poornareddy396/Underwater_ROV/electronics/README.md

# Electronics

Schematics, wiring, pinouts, power architecture and motor-control documentation.
