poornareddy396/Underwater_ROV/mechanical/README.md

# Mechanical Design

CAD models, drawings, STL files, assemblies and waterproofing-related mechanical work.
