poornareddy396/Underwater_ROV/firmware/README.md

# Firmware

STM32 embedded firmware and communication protocol documentation.
