poornareddy396/Underwater_ROV/software/README.md

# Software

Raspberry Pi software, web interface, computer vision and ground-station components.
