poornareddy396/Underwater_ROV/firmware/stm32/README.md

# STM32 Firmware

STM32F411 Blackpill CubeIDE project used by the underwater ROV. Generated build/debug artifacts are intentionally excluded from version control.
