poornareddy396/Underwater_ROV/software/raspberry_pi/README.md

# Raspberry Pi Software

Raspberry Pi application and web interface for the underwater ROV.
