poornareddy396/Underwater_ROV/mechanical/iteration_2/fusion_360_final_model.png

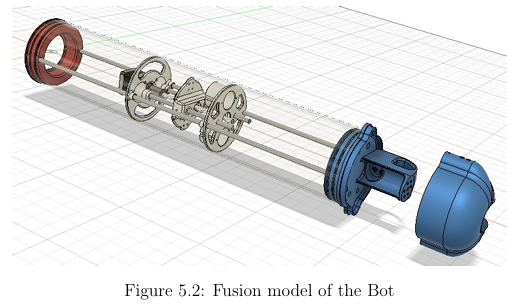
mechanical/iteration_2/fusion_360_final_model.png
