poornareddy396/Underwater_ROV/mechanical/iteration_2/mechanical_design_2_CAP_DESIGN.png

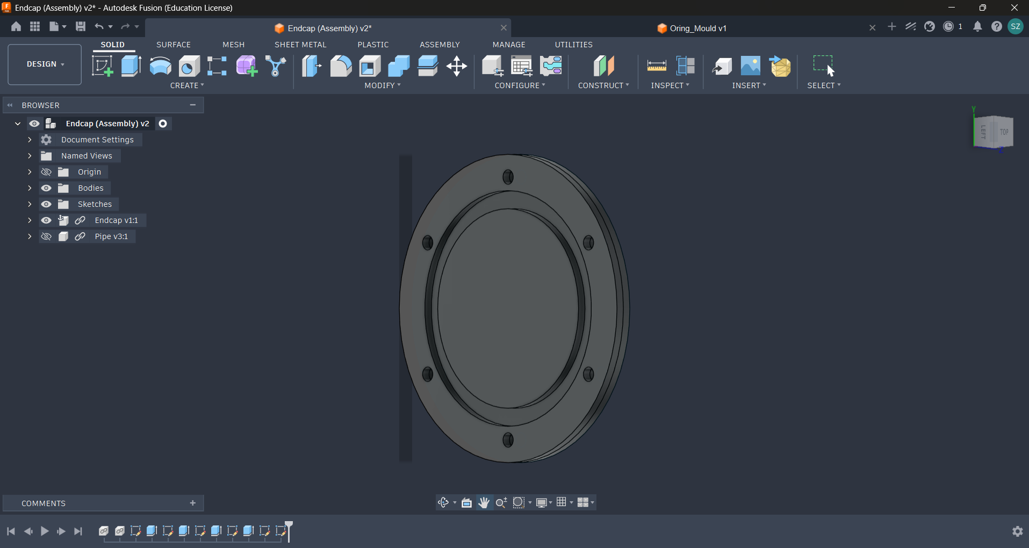
mechanical/iteration_2/mechanical_design_2_CAP_DESIGN.png
