poornareddy396/Underwater_ROV/mechanical/iteration_2/mechanical_design_2_IMG_20260821_114951.jpg

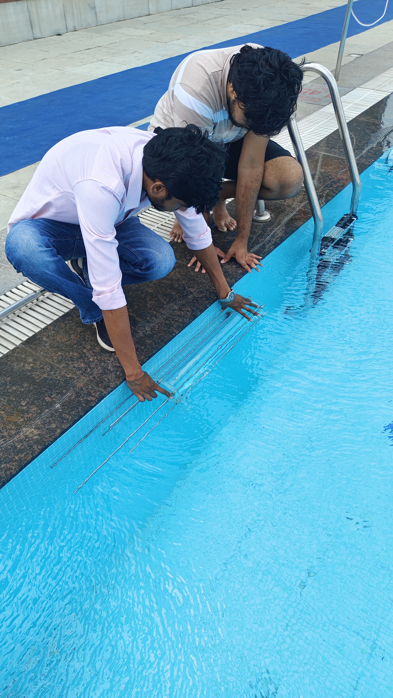
mechanical/iteration_2/mechanical_design_2_IMG_20260821_114951.jpg
