poornareddy396/Underwater_ROV/mechanical/iteration_2/mechanical_design_2_IMG_20260921_133137.jpg

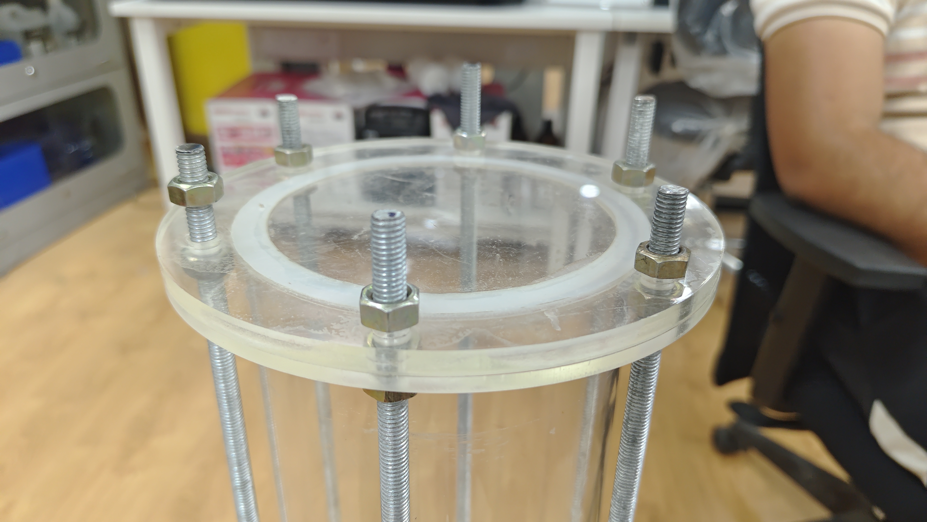
mechanical/iteration_2/mechanical_design_2_IMG_20260921_133137.jpg
