poornareddy396/Underwater_ROV/schematics/schematics_and_components.pdf

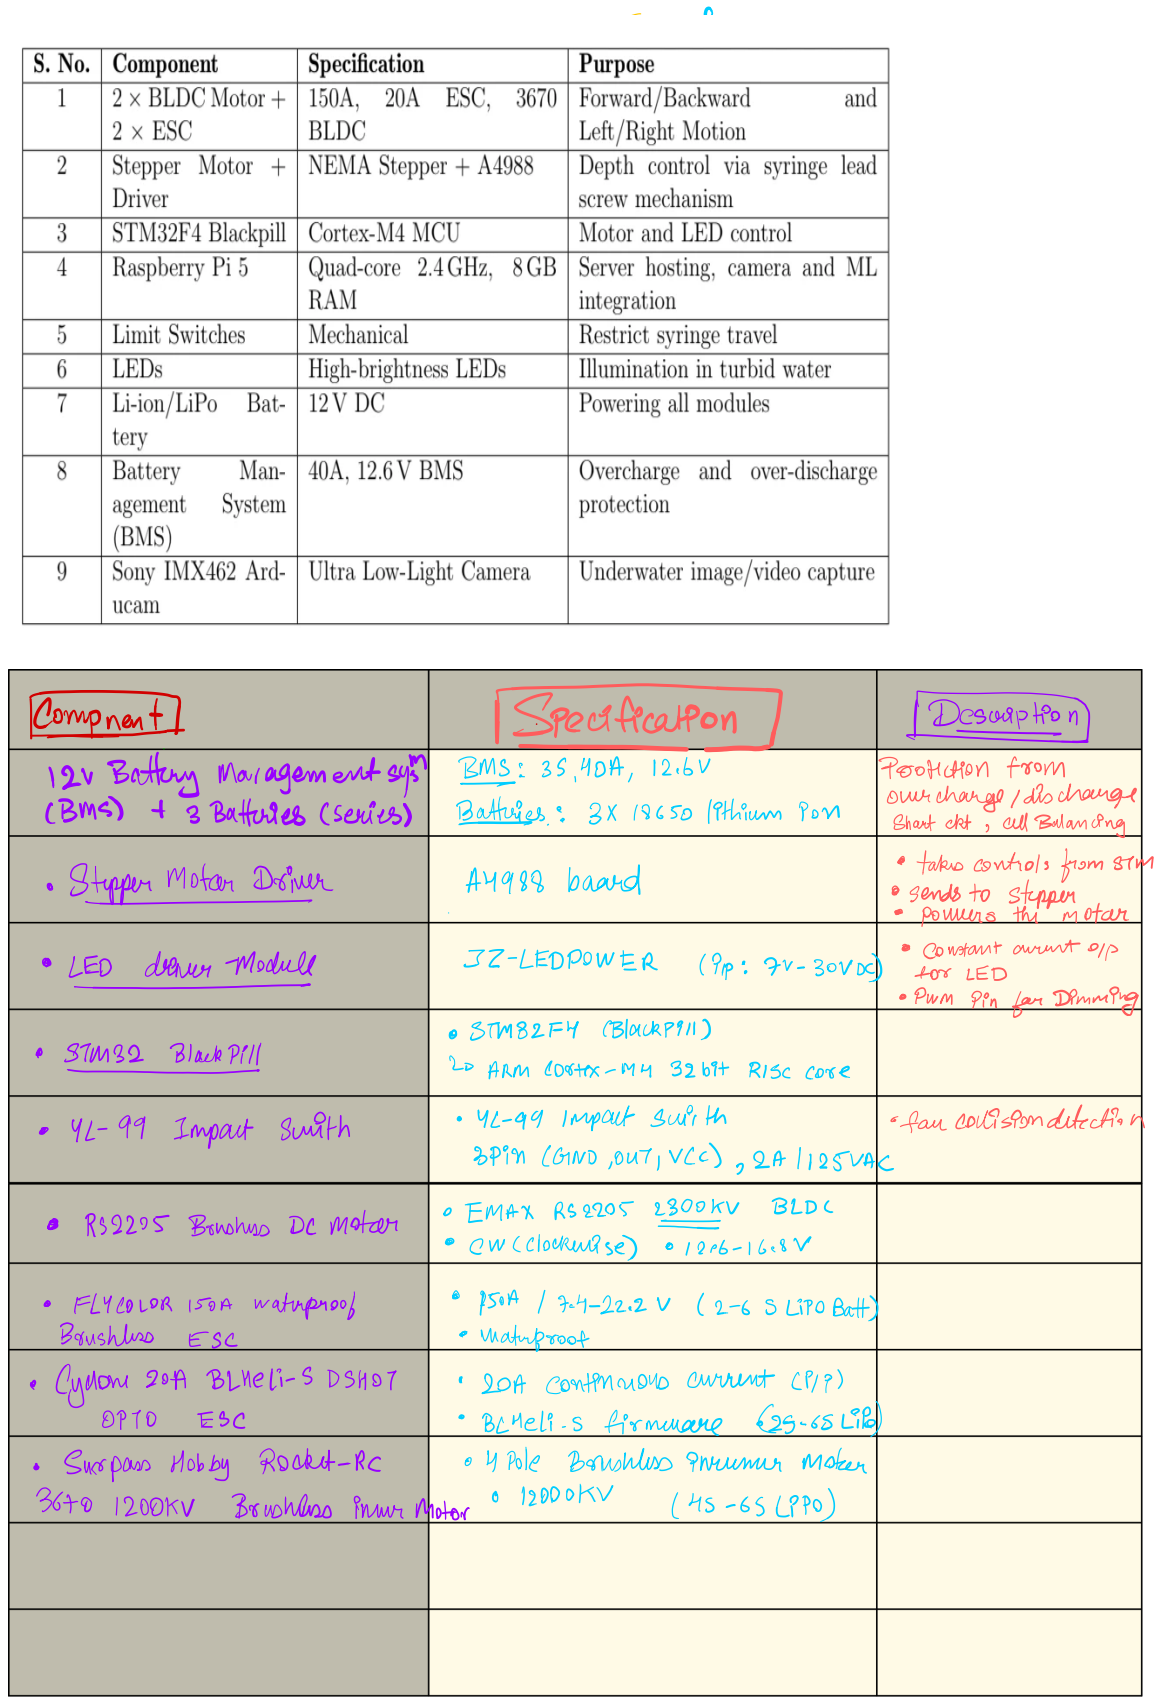
[picture p20: page 1]

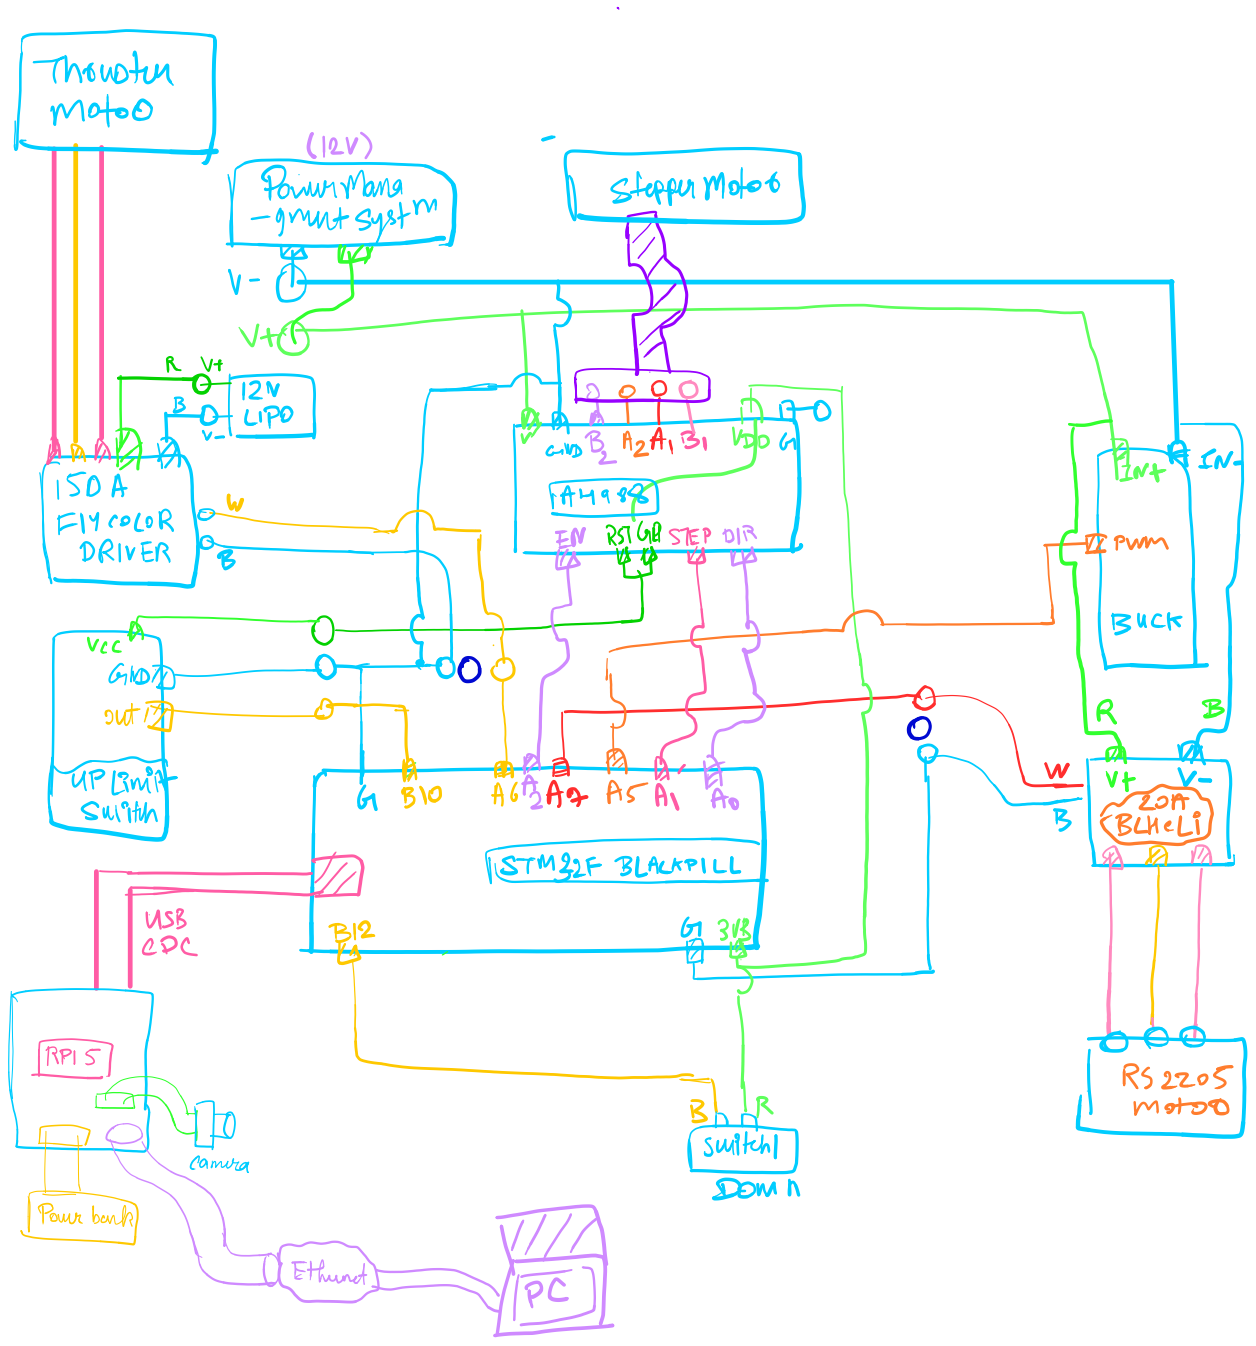
[picture p21: page 2]
