poornareddy396/Underwater_ROV/schematics/hand_drawn_electrical_wiring.png

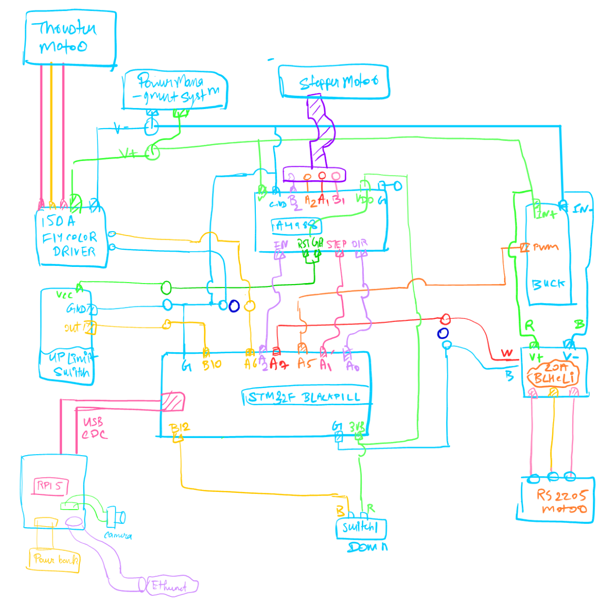
schematics/hand_drawn_electrical_wiring.png
