poornareddy396/Underwater_ROV/CHANGELOG.md

# Changelog

## Initial Repository
- Added complete project repository structure.
- Added project README.
- Added uploaded project report.
- Added documentation, mechanical, electronics, firmware, software,
  experiments, results, media, data, BOM and scripts directories.
