poornareddy396/Underwater_ROV/firmware/stm32/Core/Src/main.c

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
/* Includes ------------------------------------------------------------------*/
#include "main.h"
#include "usb_device.h"

/* USER CODE BEGIN PD */
#define MIN_PULSE 1000      // microseconds
#define MAX_PULSE 2000      // microseconds
#define MID_PULSE 1500      // microseconds

#define STAY_LOW_TIME 5000  // milliseconds
#define RAMP_TIME 15000     // milliseconds
#define EN_PIN     GPIO_PIN_2
#define STEP_PIN   GPIO_PIN_1
#define DIR_PIN    GPIO_PIN_0
#define EN_PORT    GPIOA
#define STEP_PORT  GPIOA
#define DIR_PORT   GPIOA

#define UP_LIMIT_PIN      GPIO_PIN_10   // PB10
#define DOWN_LIMIT_PIN    GPIO_PIN_12   // PB12
#define LIMIT_PORT        GPIOB
/* USER CODE END PD */

TIM_HandleTypeDef htim2;
TIM_HandleTypeDef htim3;

/* USER CODE BEGIN PV */
volatile uint8_t up_limit_reached = 0;
volatile uint8_t down_limit_reached = 0;
int right = 0;
int left = 0;
int base_pulse = 1490;
int right_min = 1300;
int left_max  = 1600;

float progress;

/* “reported�? flags so we send LIMIT:UP only once until state changes */
volatile uint8_t up_limit_reported = 0;
volatile uint8_t down_limit_reported = 0;


/* debounce timers */
uint32_t startTime = 0;
uint32_t speed = 0;
int fw_bw = 1;
int stop = 1;
int direction = 1;
unsigned long lastDebounceUp = 0;
unsigned long lastDebounceDown = 0;
const unsigned long debounceDelay = 50;
uint8_t light = 0;
uint8_t fw_mot_start = 0;
extern uint8_t CDC_Transmit_FS(uint8_t* Buf, uint16_t Len);
/* USER CODE END PV */

void SystemClock_Config(void);
static void MX_GPIO_Init(void);
static void MX_TIM3_Init(void);
static void MX_TIM2_Init(void);
/* USER CODE BEGIN 0 */

//void check_limit_switches(void) {
//    static uint8_t last_up_state = 0;
//    static uint8_t last_down_state = 0;
//
//    uint8_t up_state = HAL_GPIO_ReadPin(LIMIT_PORT, UP_LIMIT_PIN);
//    uint8_t down_state = HAL_GPIO_ReadPin(LIMIT_PORT, DOWN_LIMIT_PIN);
//
//    if (up_state && !last_up_state) {
//        up_limit_reached = 1;
//        CDC_Transmit_FS((uint8_t*)"LIMIT:UP\n", strlen("LIMIT:UP\n"));
//    }
//    else if (!up_state && last_up_state) {
//        up_limit_reached = 0;
//        CDC_Transmit_FS((uint8_t*)"LIMIT:CLEAR\n", strlen("LIMIT:CLEAR\n"));
//    }
//
//    if (down_state && !last_down_state) {
//        down_limit_reached = 1;
//        CDC_Transmit_FS((uint8_t*)"LIMIT:DOWN\n", strlen("LIMIT:DOWN\n"));
//    }
//    else if (!down_state && last_down_state) {
//        down_limit_reached = 0;
//        CDC_Transmit_FS((uint8_t*)"LIMIT:CLEAR\n", strlen("LIMIT:CLEAR\n"));
//    }
//
//    last_up_state = up_state;
//    last_down_state = down_state;
//}

void delay_us(uint32_t us)
{
  uint32_t start = DWT->CYCCNT;
  uint32_t ticks = us * (HAL_RCC_GetHCLKFreq() / 1000000);
  while ((DWT->CYCCNT - start) < ticks);
}
void singleStep(int dir, int speed_us)
{
  HAL_GPIO_WritePin(DIR_PORT, DIR_PIN, dir ? GPIO_PIN_SET : GPIO_PIN_RESET);
  HAL_GPIO_WritePin(STEP_PORT, STEP_PIN, GPIO_PIN_SET);
  delay_us(speed_us);
  HAL_GPIO_WritePin(STEP_PORT, STEP_PIN, GPIO_PIN_RESET);
  delay_us(speed_us);
}

/* USER CODE BEGIN 0 */
void HAL_GPIO_EXTI_Callback(uint16_t GPIO_Pin)
{
    uint32_t current = HAL_GetTick();

    if (GPIO_Pin == UP_LIMIT_PIN)
    {
        if ((current - lastDebounceUp) > debounceDelay)
        {
            lastDebounceUp = current;
            up_limit_reached = 1;         // tell main loop we hit top limit
            //up_limit_reported = 0;// allow main to report once
            down_limit_reached = 0;
        }
    }
    else if (GPIO_Pin == DOWN_LIMIT_PIN)
    {
        if ((current - lastDebounceDown) > debounceDelay)
        {
            lastDebounceDown = current;
            down_limit_reached = 1;
            //down_limit_reported = 0;
            up_limit_reached = 0;
        }
    }
}
int set_motor_speed_fw(uint32_t speed_percent) {
    if (speed_percent > 100) speed_percent = 100;

    // Map 0–100 → 1000–1500 µs
    uint32_t pulse = MID_PULSE + ((MAX_PULSE - MID_PULSE) * speed_percent) / 100;

    return pulse;

}
int set_motor_speed_bw(uint32_t speed_percent) {
    if (speed_percent > 100) speed_percent = 100;

    // Map 0–100 → 1000–1500 µs
    uint32_t pulse = MID_PULSE - ((MAX_PULSE - MID_PULSE) * speed_percent) / 100;

    return pulse;

}
/* USER CODE END 0 */

/**
  * @brief  The application entry point.
  * @retval int
  */
int main(void)
{

  /* MCU Configuration--------------------------------------------------------*/

  /* Reset of all peripherals, Initializes the Flash interface and the Systick. */
  HAL_Init();

  /* Configure the system clock */
  SystemClock_Config();

  /* Initialize all configured peripherals */
  MX_GPIO_Init();
  MX_USB_DEVICE_Init();
  MX_TIM3_Init();
  MX_TIM2_Init();
  /* USER CODE BEGIN 2 */
  HAL_GPIO_WritePin(EN_PORT, EN_PIN, GPIO_PIN_SET);  // Disable
  HAL_GPIO_WritePin(DIR_PORT, DIR_PIN, GPIO_PIN_RESET);
  HAL_GPIO_WritePin(STEP_PORT, STEP_PIN, GPIO_PIN_RESET);

      //HAL_GPIO_WritePin(EN_PORT, EN_PIN, GPIO_PIN_RESET); // Enable driver

      // Enable DWT Cycle Counter for microsecond delay
      CoreDebug->DEMCR |= CoreDebug_DEMCR_TRCENA_Msk;
      DWT->CYCCNT = 0;
      DWT->CTRL |= DWT_CTRL_CYCCNTENA_Msk;

      HAL_TIM_PWM_Start(&htim3, TIM_CHANNEL_1);
      HAL_TIM_PWM_Start(&htim3, TIM_CHANNEL_2);
      HAL_TIM_PWM_Start(&htim2, TIM_CHANNEL_1);
        startTime = HAL_GetTick();
  /* USER CODE END 2 */

  /* Infinite loop */
  /* USER CODE BEGIN WHILE */
  while (1)
  {

//	  check_limit_switches();
	  if (up_limit_reached)
	      {
	          // disable driver (active low enable in your code)
	          HAL_GPIO_WritePin(EN_PORT, EN_PIN, GPIO_PIN_SET); // disable motor driver

//	          if (!up_limit_reported)
//	          {
//	              // send event to host once
//	              CDC_Transmit_FS((uint8_t*)"LIMIT:UP\n", (uint16_t)strlen("LIMIT:UP\n"));
//	              up_limit_reported = 1;
//	          }

	          // do not step
	          HAL_Delay(1); // small delay to keep loop friendly
	      }
	      else if (down_limit_reached)
	      {
	          HAL_GPIO_WritePin(EN_PORT, EN_PIN, GPIO_PIN_SET); // disable driver

//	          if (!down_limit_reported)
//	          {
//	              CDC_Transmit_FS((uint8_t*)"LIMIT:DOWN\n", (uint16_t)strlen("LIMIT:DOWN\n"));
//	              down_limit_reported = 1;
//	          }
	          HAL_Delay(1);
	      }
	      else
	      {
	          // normal stepping: ensure driver enabled (active low)

	          if(stop) HAL_GPIO_WritePin(EN_PORT, EN_PIN, GPIO_PIN_SET); // disable motor driver
	          else HAL_GPIO_WritePin(EN_PORT, EN_PIN, GPIO_PIN_RESET);
	          // do one step (existing function)
	          singleStep(direction, 1000);
	      }

	  uint32_t elapsed = HAL_GetTick() - startTime;
	  	  	      uint32_t pulse_width;
	  	  	      uint32_t pulse;


	  	  	      if (elapsed < STAY_LOW_TIME)
	  	  	      {
	  	  	        pulse_width = MID_PULSE;
	  	  	    __HAL_TIM_SET_COMPARE(&htim3, TIM_CHANNEL_2, 1490);
	  	  	      }
	  	  	     else
	  	  	      {
	  	  	    	 if (fw_bw) pulse_width = set_motor_speed_fw(speed);
	  	  	    	 else pulse_width = set_motor_speed_bw(speed);
	  	  	    	if (right && !left)
	  	  	    	{
	  	  	    	    progress = (float)(elapsed - STAY_LOW_TIME) / RAMP_TIME;
	  	  	    	    if (progress < 0) progress = 0;
	  	  	    	    if (progress > 1) progress = 1;

	  	  	    	    pulse = base_pulse - progress * (base_pulse - right_min);

	  	  	    	    __HAL_TIM_SET_COMPARE(&htim3, TIM_CHANNEL_2, pulse);
	  	  	    	}

	  	  	    	// ----------- LEFT ----------------
	  	  	    	else if (left && !right)
	  	  	    	{
	  	  	    	    progress = (float)(elapsed - STAY_LOW_TIME) / RAMP_TIME;
	  	  	    	    if (progress < 0) progress = 0;
	  	  	    	    if (progress > 1) progress = 1;

	  	  	    	    pulse = base_pulse + progress * (left_max - base_pulse);

	  	  	    	    __HAL_TIM_SET_COMPARE(&htim3, TIM_CHANNEL_2, pulse);
	  	  	    	}

	  	  	    	// ----------- NEUTRAL -------------
	  	  	    	else
	  	  	    	{
	  	  	    	    pulse = base_pulse;
	  	  	    	    __HAL_TIM_SET_COMPARE(&htim3, TIM_CHANNEL_2, pulse);
	  	  	    	}
	  	  	      }

	  	  	      // Set pulse width (duty cycle)
	  	  	      if(fw_mot_start) __HAL_TIM_SET_COMPARE(&htim3, TIM_CHANNEL_1, pulse_width);
	  	  	      else __HAL_TIM_SET_COMPARE(&htim3, TIM_CHANNEL_1, MID_PULSE);
	  	  	      if(light) __HAL_TIM_SET_COMPARE(&htim2, TIM_CHANNEL_1, 5000);
	  	  	      else __HAL_TIM_SET_COMPARE(&htim2, TIM_CHANNEL_1, 0);
    /* USER CODE END WHILE */

    /* USER CODE BEGIN 3 */
  }
  /* USER CODE END 3 */
}

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
