poornareddy396/Underwater_ROV/firmware/stm32/Rpi_com.ioc

Mcu.UserName=STM32F411CEUx
PA0-WKUP.Signal=GPIO_Output
PA1.Signal=GPIO_Output
PA11.Signal=USB_OTG_FS_DM
PA12.Signal=USB_OTG_FS_DP
PA13.Signal=SYS_JTMS-SWDIO
PA14.Signal=SYS_JTCK-SWCLK
PA2.Signal=GPIO_Output
PA5.Signal=S_TIM2_CH1_ETR
PA6.Signal=S_TIM3_CH1
PA7.Signal=S_TIM3_CH2
PB10.Signal=GPXTI10
PB12.Signal=GPXTI12
