poornareddy396/Underwater_ROV/(commit log)

2026-09-23 Add STM32 firmware and Raspberry Pi software
2026-09-23 Add mechanical designs, schematics, images and videos
2026-09-23 Organize mechanical iterations and schematics
