poornareddy396/Underwater_ROV/mechanical/iteration_2/mechanical_design_2_20260821_115327.jpg

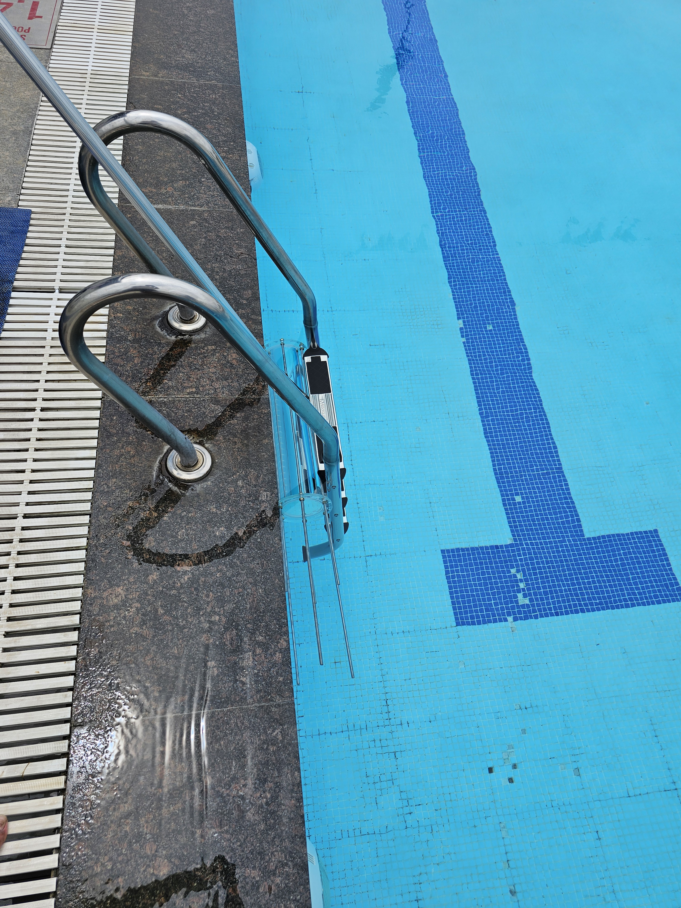
mechanical/iteration_2/mechanical_design_2_20260821_115327.jpg
